inspireFly-VT/Pocketqube-child-antennaBoard/README.md

# Pocketqube-child-antennaBoard
~430 MHz antenna board, integrating a RFM98W transceiver.
