inspireFly-VT/Pocketqube-child-antennaBoard/Task_List_Antenna.txt

Tasks:
- We need to determine the length of the traces we're going to use going from the transceiver to the tape antenna, we'll use https://jlcpcb.com/pcb-impedance-calculator, we need an impedance of 50 ohms to match the transceiver and the antenna we're going to design.
- May need to talk to mechanical in terms of deployment of our antenna
- Same 5x5 design, decide where the mounting holes are, mechanical has not given us direction on it yet. Also make it slightly smaller than 5x5, so that there's a small amount of tolerance for mechanical.
- The Antenna will sit on the PCB and the deployment method will also be on the PCB, however we need to figure out a way to connect it, so far we want a pad that the antenna will connect to via SMD. We want the PCB to have zero copper under where it's mounted in order to reduce capacitance. For our ground plane we'll be using the chassis since it'll be our largest grounding point. 
- Integrate the burn wire on antenna board, it'll operate at 4.2V at about 6A
- Look into using digital input/output to control PMOS from RFM chip. Ensure that the NMOS can handle sufficient voltage and current
- Figure out a deployment method (wrap around or spool)
- "Trace crosstalk with vias". Goes hand-in-hand with via stiching. In terms of getting rid of any energy on the traces going from the transceiver to the antenna itself. KiCad has some stuff we can use to automate and implement this. Mounting of antenna will likely cause some kind of reactance added to the transmission line. VIA stitching gives us a hard ground plane which, helps to maintain the integrity of the signal.
- Look into making the PCB 4 layers instead of two in order to better implement VIA stitching.

Completed Tasks:
- Ask Shane to make a separate Antenna Board repo - DONE
- We need to determine the length of the tape antenna we're going to use, for this we need to do research into the tape antenna and how it functions - DONE
- We need a 4-5 pin connector and implement an interrupt. The connector will go between the main board and the antenna board. Look into specific non-coaxial connectors that will maintain our use case for RF applications - DONE
- We're back to a monopole antenna, for this we only need our transceiver to have one output, because of this, we can continue to use the RFM98W-433S2 transceiver. - DONE
- Alek said the main requirements for our transceiver is for it to have Frequency Shift Keying (FSK) and a high dbi output. We can maybe look into a better transceiver if we want to. - DONE
- We need to find a connector with more connection so we can a 4.2V path for the burn wire/resistor - DONE
