inspireFly-VT/Pocketqube-child-antennaBoard/ChildAntenna_BOM.xlsx

Sheet: Ordering Sheet
Distributor | Part Number | Part Description | Quantity Per Board
Digikey | GRM32ER71E226KE15L | CAP CER 22UF 25V X7R 1210 | 3
Digikey | CL05B104KA5NNNC | CAP CER 0.1UF 25V X7R 0402 | 1
Mouser | RFM98W-433S2 | RFM98W-433S2 | 1
Digikey | M55-7101242R | CONN HEADER SMD R/A 12POS 1.27MM | 3
Digikey | M55-7102642R | CONN HEADER SMD R/A 26POS 1.27MM | 1

Sheet: BOM Comparison
 | Sourced | Placed | References | Value | Footprint | Quantity
1 |  |  | C3, C4, C5 | 22uF | C_1210_3225Metric | 3
2 |  |  | C1 | 100nF | C_0402_1005Metric_Pad0.74x0.62mm_HandSolder | 1
3 |  |  | AE1 | Antenna | Tape Antenna | 1
4 |  |  | MOD1 | RFM98W-433S2 | XCVR_RFM98W-433S2 | 1
5 |  |  | J2, J3, J4 | M55-7101242R | HARWIN_M55-7101242R | 3
6 |  |  | J1 | M55-7102642R | HARWIN_M55-7102642R | 1
