inspireFly-VT/Pocketqube-child-antennaBoard/pocketcube_child_board/pocketcube_child_board.step

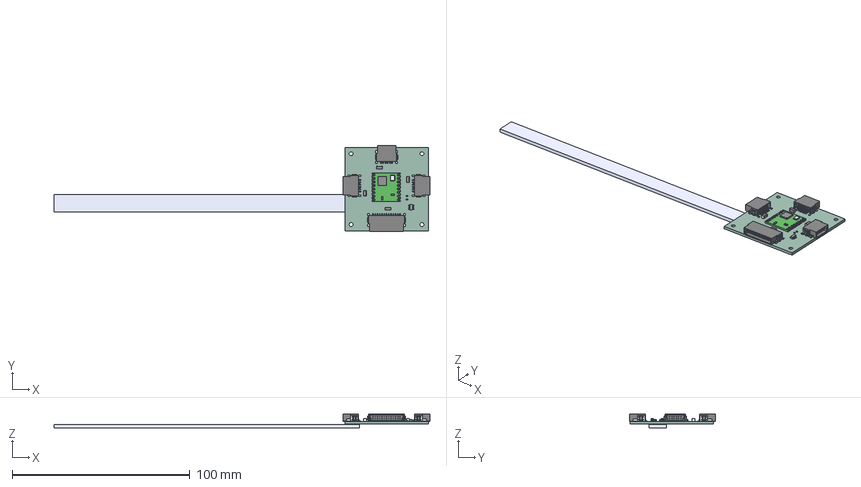
[picture p1: CAD file, 2026-03-20]
pocketcube_child_board/pocketcube_child_board.step
211.6 x 48.2 x 7.78 mm
C_1206_3216Metric x 4
C_0402_1005Metric
RFM98W-433S2
SOT_V-T1-GE3_VIS
R_0402_1005Metric
RF_Copper_Antenna_Model
pocketcube_child_board_PCB
