inspireFly-VT/Pocketqube-child-antennaBoard/pocketcube_child_board/3D Files/SOT_V-T1-GE3_VIS.step

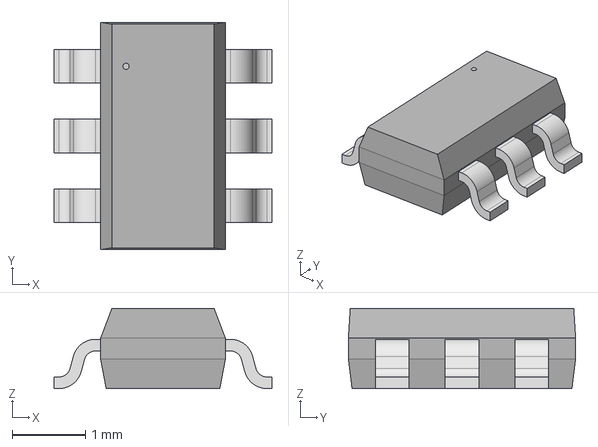
[picture p2: CAD file, 2025-11-05]
pocketcube_child_board/3D Files/SOT_V-T1-GE3_VIS.step
2.97 x 3.10 x 1.09 mm
