inspireFly-VT/Pocketqube-child-antennaBoard/pocketcube_child_board/3D Files/RFM98W-433S2.STEP

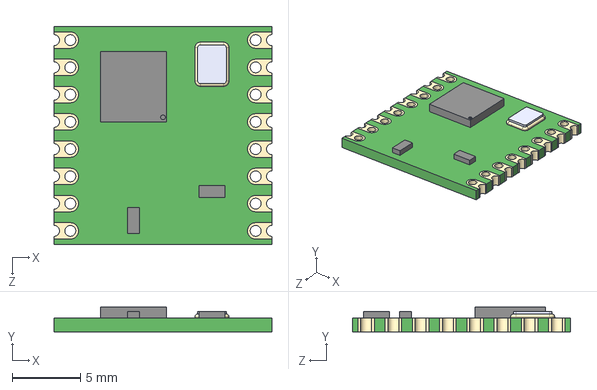
[picture p3: CAD file, 2025-10-16]
pocketcube_child_board/3D Files/RFM98W-433S2.STEP
16.0 x 1.80 x 16.0 mm
