inspireFly-VT/Pocketqube-child-antennaBoard/pocketcube_child_board/3D Files/RF_Copper_Antenna_Model.STEP

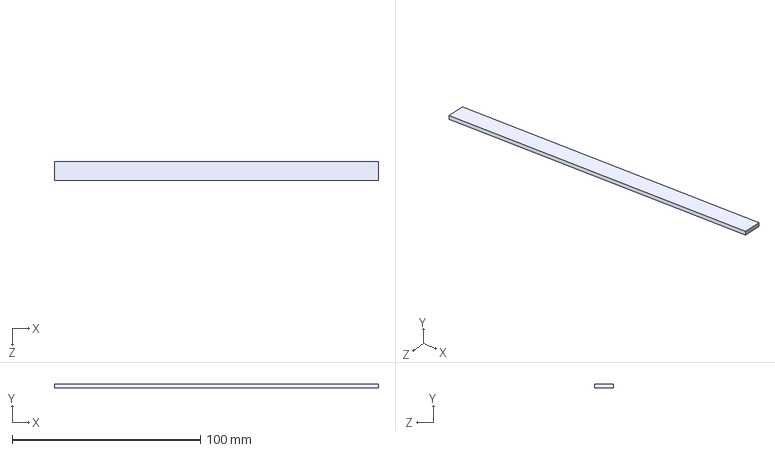
[picture p4: CAD file, 2025-10-16]
pocketcube_child_board/3D Files/RF_Copper_Antenna_Model.STEP
172.0 x 2.00 x 10.0 mm
