inspireFly-VT/Pocketqube-child-antennaBoard/pocketcube_child_board/3D Files/m55-7102642r.stp

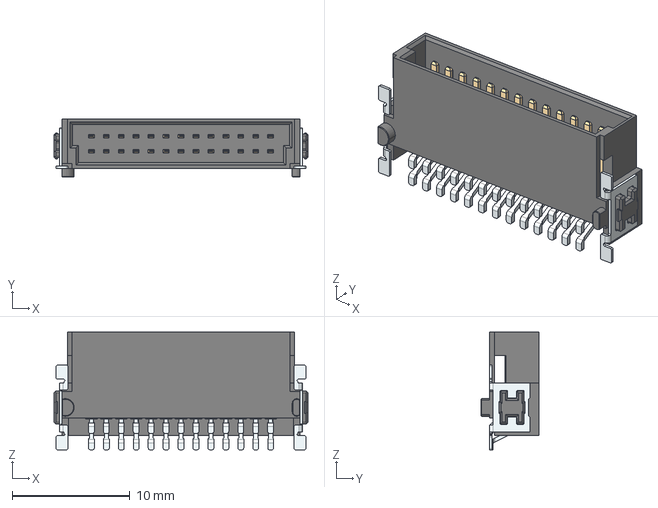
[picture p5: CAD file, 2026-03-10]
pocketcube_child_board/3D Files/m55-7102642r.stp
21.6 x 4.95 x 10.0 mm
