inspireFly-VT/Pocketqube-child-antennaBoard/pocketcube_child_board/3D Files/m55-7102042r.stp

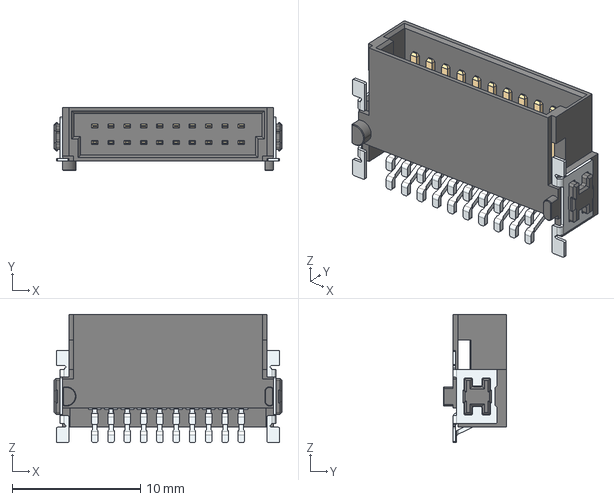
[picture p6: CAD file, 2025-10-23]
pocketcube_child_board/3D Files/m55-7102042r.stp
17.8 x 4.95 x 10.0 mm
