inspireFly-VT/Pocketqube-child-antennaBoard/pocketcube_child_board/3D Files/m55-7101242r.stp

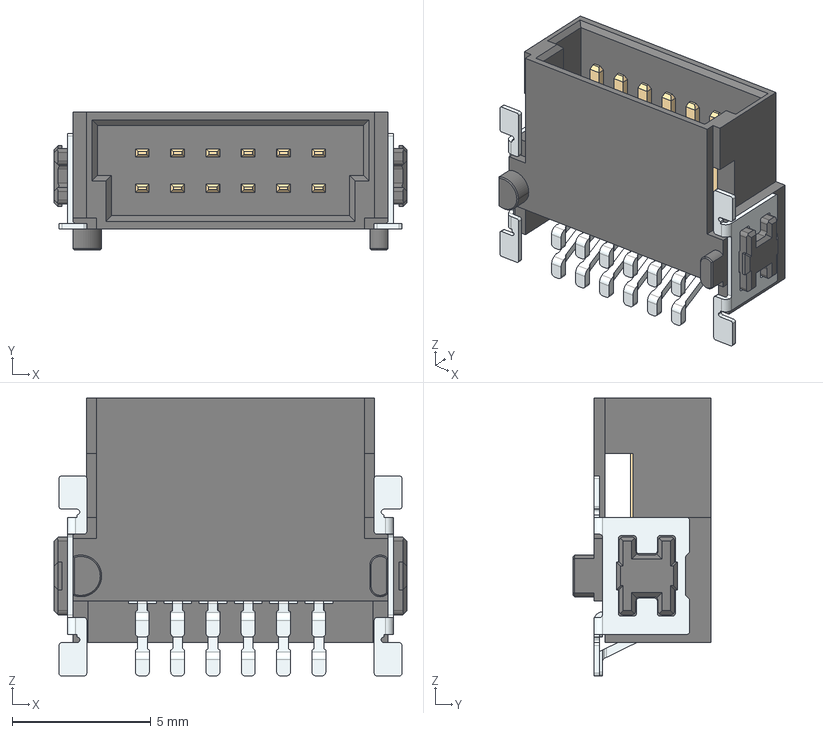
[picture p7: CAD file, 2025-10-16]
pocketcube_child_board/3D Files/m55-7101242r.stp
12.7 x 4.95 x 10.0 mm
