inspireFly-VT/Pocketqube-child-antennaBoard/pocketcube_child_board/pocketcube_child_board.kicad_pcb

## KiCad design pocketcube_child_board/pocketcube_child_board.kicad_pcb (2026-05-04)

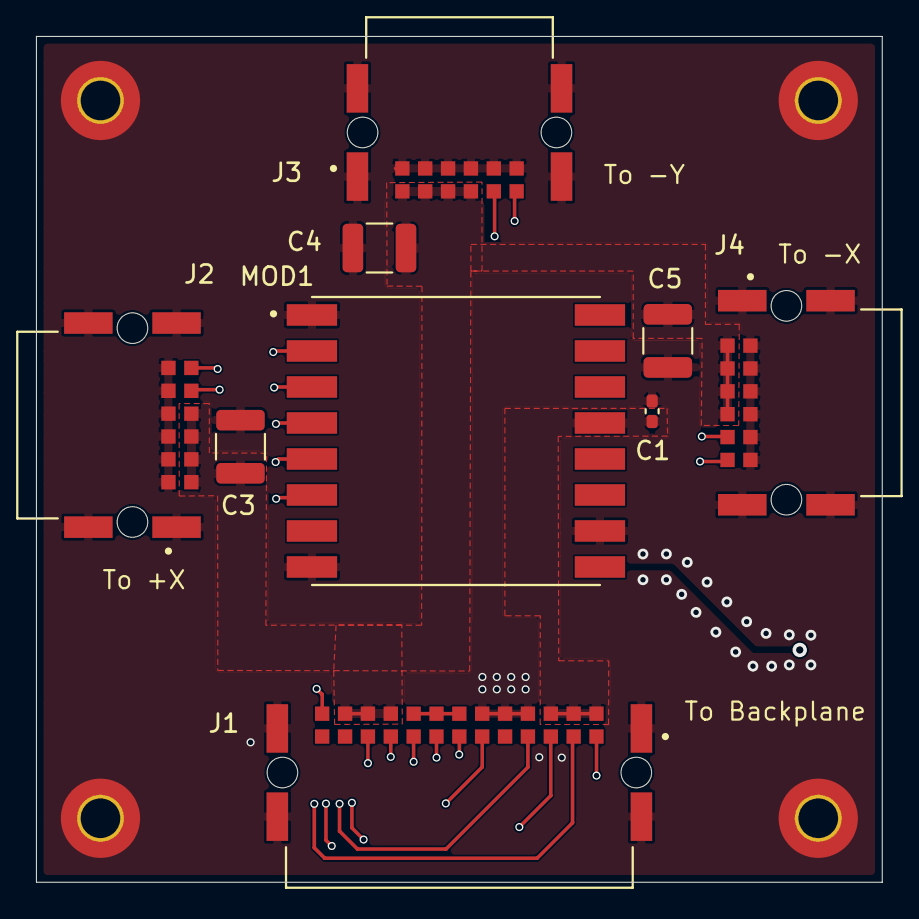
[picture p8: board pocketcube_child_board.kicad_pcb from above]

Board: 4 copper layers, 47.0 x 47.0 mm, 14 parts (1 on the bottom side), 16 nets.

Parts:
AE1: Antenna; Tape Antenna
C1: 100nF; C_0402_1005Metric_Pad0.74x0.62mm_HandSolder
C3, C4, C5: 22uF; C_1210_3225Metric
H1, H2, H3, H4: MountingHole_Pad; MountingHole_2.2mm_M2_Pad_TopBottom
J1: M55-7102642R; HARWIN_M55-7102642R
J2, J3, J4: M55-7101242R; HARWIN_M55-7101242R
MOD1: RFM98W-433S2; XCVR_RFM98W-433S2

Connections:
+3.3V: C1.2, J1.B1, J1.B2, J1.B3, MOD1.13 (3.3V)
/ANTENNA_TRACE: AE1.1 (A_1), MOD1.9 (ANT)
ANT_SPI2_MISO: J1.A2, MOD1.2 (MISO)
ANT_SPI2_MOSI: J1.A1, MOD1.3 (MOSI)
ANT_SPI2_NSS: J1.A3, MOD1.5 (NSS)
ANT_SPI2_SCK: J1.A4, MOD1.4 (SCK)
BAT_VOLTAGE: J1.B7, J1.B8, J1.B9
EXTERNAL_VOLTAGE: C3.2, C4.2, C5.2, J1.B10, J1.B11, J1.B12, J2.B1, J2.B2, J2.B3, J2.B4, J3.B1, J3.B2, J3.B3, J3.B4, J4.B1, J4.B2, J4.B3, J4.B4
GND: C1.1, C3.1, C4.1, C5.1, H1.1 (1_1), H2.1 (1_1), H3.1 (1_1), H4.1 (1_1), J1.B4, J1.B5, J1.B6, J1.SH1, J1.SH2, J1.SH3, J1.SH4, J2.A1, J2.A2, J2.A3, J2.A4, J2.A5, J2.A6, J2.SH1, J2.SH2, J2.SH3, J2.SH4, J3.A1, J3.A2, J3.A3, J3.A4, J3.A5, J3.A6, J3.SH1, J3.SH2, J3.SH3, J3.SH4, J4.A1, J4.A2, J4.A3, J4.A4, J4.A5, J4.A6, J4.SH1, J4.SH2, J4.SH3, J4.SH4, MOD1.1 (GND), MOD1.8 (GND__2), MOD1.10 (GND__4)
I2C1_SCL: J1.A7, J2.B5
I2C1_SDA: J1.A6, J2.B6
I2C2_SCL: J1.A9, J3.B5
I2C2_SDA: J1.A8, J3.B6
I2C3_SCL: J1.A11, J4.B5
I2C3_SDA: J1.A10, J4.B6
RFM_RESET: J1.B13, MOD1.6 (RESET)
