inspireFly-VT/Pocketqube-child-antennaBoard/(commit log)

2025-10-14 Creating KiCad Project
    Created the KiCad project for the child board. Did not update the LOCK file as I have not edited/worked on anything on the schematic/PCB
    [pocketcube_child_board.kicad_pcb, pocketcube_child_board.kicad_sch]
2025-10-15 Beginning to work on antenna schematic
2025-10-15 Finished Working
    [pocketcube_child_board.kicad_pcb, pocketcube_child_board.kicad_sch]
2025-10-16 Fixed footprints
    [RFM98W-433S2.STEP, RF_Copper_Antenna_Model.STEP, m55-7101242r.stp, pocketcube_child_board.kicad_pcb]
2025-10-23 Added new connector to PCB
    [m55-7102042r.stp, pocketcube_child_board.kicad_pcb, pocketcube_child_board.kicad_sch]
2025-10-26 Adding cap and finishing review
    See teams message
    [pocketcube_child_board.kicad_sch]
2025-11-02 11/2 via stitching v0.1
    [pocketcube_child_board.kicad_pcb]
2025-11-02 Testing push capabilities for current folder
2025-11-04 Edited PCB Layout & Rearranged Pins
    I restructured the layout of the PCB due to traces going under the components, I also changed the pin order of the connector to add with routing
    [pocketcube_child_board.kicad_pcb, pocketcube_child_board.kicad_sch]
2025-11-05 Added SI3477DV-T1-GE3 P-Channel MOSFET to Schematic and PCB
    [SOT_V-T1-GE3_VIS.step, pocketcube_child_board.kicad_pcb, pocketcube_child_board.kicad_sch]
2025-11-05 Integrating P-Channel MOSFET
    [pocketcube_child_board.kicad_pcb, pocketcube_child_board.kicad_sch]
2025-11-09 implemented pmos
    [pocketcube_child_board.kicad_pcb]
2025-11-09 pmos implementation
    [pocketcube_child_board.kicad_pcb, pocketcube_child_board.kicad_sch]
2025-11-09 Revert "pmos implementation"
    This reverts commit 559285578e66f978812a0fb110e98bc36d41d9a4.
    [pocketcube_child_board.kicad_pcb, pocketcube_child_board.kicad_sch]
2025-11-09 PMOS Implementation and Ground Plane
    [pocketcube_child_board.kicad_pcb, pocketcube_child_board.kicad_sch]
2026-03-10 Pushing Board sizes
    [m55-7102642r.stp, pocketcube_child_board.kicad_pcb, pocketcube_child_board.kicad_sch, pocketcube_child_board.step]
2026-03-20 Antenna location changes
    [pocketcube_child_board.kicad_pcb, pocketcube_child_board.step]
2026-03-30 updated antenna traces
    [pocketcube_child_board.kicad_pcb]
2026-04-01 stuff from HITT
    [pocketcube_child_board.kicad_pcb]
2026-04-12 4 layer board routing
    2 ground layers between front and backplane to increase rf performance, may need to use for routing though
    [pocketcube_child_board.kicad_pcb]
2026-04-19 Pushing Routing Changes
    [pocketcube_child_board.kicad_pcb, pocketcube_child_board.kicad_sch]
2026-05-03 Updates due to changes from backplane
    [pocketcube_child_board.kicad_pcb, pocketcube_child_board.kicad_sch]
2026-05-04 BOM work + silkscreen
    [ChildAntenna_BOM.xlsx, bom.csv, designators.csv, pocketcube_child_board.kicad_pcb, positions.csv]
